IowaDave/ATtiny_Soil_Sentinel/images/IMG_2849.jpg

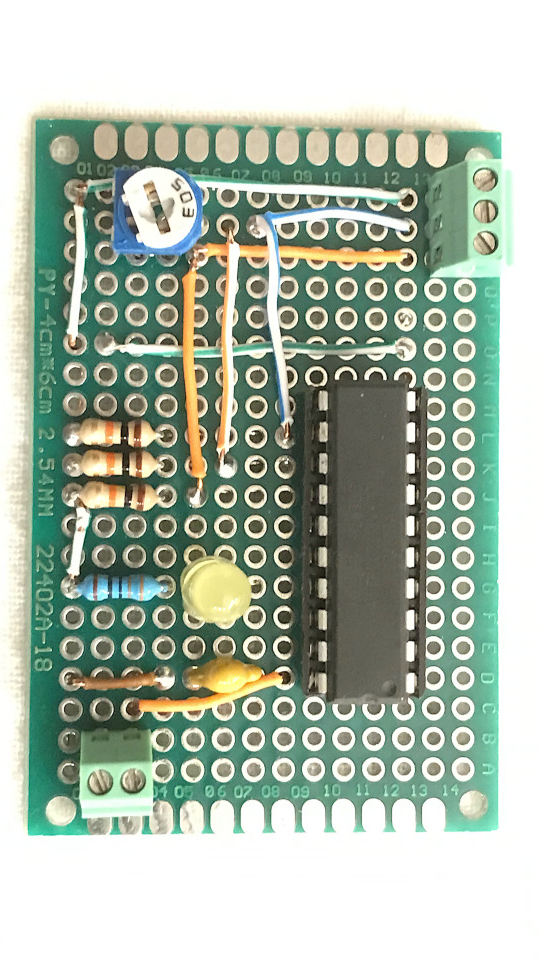
images/IMG_2849.jpg
