IowaDave/ATtiny_Soil_Sentinel/images/schematic_Vbg.png

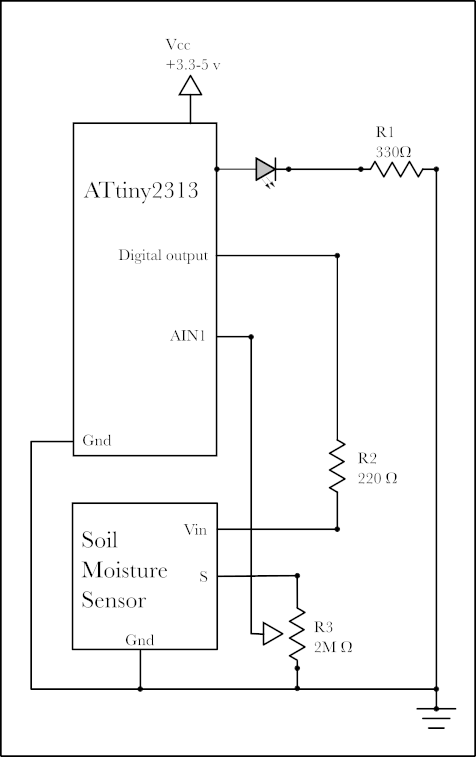
images/schematic_Vbg.png
