IowaDave/ATtiny_Soil_Sentinel/(commit log)

2022-06-29 Connect and calibrate
2022-07-03 Upload schematic
2022-07-03 Include schematic
2022-07-26 Add schematic_Vbg
